mushahid-intesum/3d-obj-detection/python/merge_sessions.py

import os
import json
import glob
import time

import numpy as np
from PIL import Image

DATA_ROOT           = "./data"
OUTPUT_DIR          = "./data/merged"
MIN_SEGMENT_LENGTH  = 5
IMG_SIZE            = 96


def discover_sessions(data_root):
    sessions = []
    for entry in sorted(os.listdir(data_root)):
        subdir = os.path.join(data_root, entry)
        traj_path = os.path.join(subdir, "trajectory.jsonl")
        if os.path.isdir(subdir) and os.path.isfile(traj_path):
            sessions.append(subdir)

    sessions = [s for s in sessions if os.path.abspath(s) !=
                os.path.abspath(OUTPUT_DIR)]

    print(f"[Discover] Found {len(sessions)} sessions:")
    for s in sessions:
        print(f"  - {os.path.basename(s)}")
    return sessions


def load_session(session_dir):
    traj_path = os.path.join(session_dir, "trajectory.jsonl")
    img_dir = os.path.join(session_dir, "images")

    trajectory = []
    with open(traj_path, "r") as f:
        for line in f:
            line = line.strip()
            if line:
                trajectory.append(json.loads(line))

    if not trajectory:
        print(f"  [WARN] Empty trajectory in {session_dir}")
        return None, None

    frames = []
    for step in trajectory:
        img_path = os.path.join(img_dir, step["frame"])
        if not os.path.exists(img_path):
            print(f"  [WARN] Missing image: {img_path}")
            return None, None
        img = Image.open(img_path).convert("RGB")
        if img.size != (IMG_SIZE, IMG_SIZE):
            img = img.resize((IMG_SIZE, IMG_SIZE), Image.LANCZOS)
        frames.append(np.array(img, dtype=np.uint8))

    frames = np.stack(frames, axis=0)
    return frames, trajectory


def find_segments(trajectory, min_length=MIN_SEGMENT_LENGTH):
    segments = []
    seg_start = 0

    for i, step in enumerate(trajectory):
        if step.get("blocked", False):
            if i - seg_start >= min_length:
                segments.append((seg_start, i))
            seg_start = i + 1

    if len(trajectory) - seg_start >= min_length:
        segments.append((seg_start, len(trajectory)))

    return segments


def main():
    print("=" * 50)
    print("  Merge Exploration Sessions")
    print("=" * 50)

    t_start = time.time()
    os.makedirs(OUTPUT_DIR, exist_ok=True)

    sessions = discover_sessions(DATA_ROOT)
    if not sessions:
        print("\n[ERROR] No sessions found. Run receiver.py first.")
        return

    all_segments = []
    total_frames = 0

    for sess_dir in sessions:
        print(f"\n[*] Loading: {os.path.basename(sess_dir)}")
        frames, trajectory = load_session(sess_dir)
        if frames is None:
            continue

        segments = find_segments(trajectory)
        print(f"    {len(frames)} frames → {len(segments)} segments")

        for seg_start, seg_end in segments:
            seg_len = seg_end - seg_start
            seg_frames = frames[seg_start:seg_end]
            seg_actions = np.array([
                trajectory[i]["action"] for i in range(seg_start, seg_end)
            ], dtype=np.int32)
            seg_headings = np.array([
                trajectory[i].get("heading", 0.0) for i in range(seg_start, seg_end)
            ], dtype=np.float32)
            seg_proximity = np.array([
                trajectory[i].get("proximity", 255.0) for i in range(seg_start, seg_end)
            ], dtype=np.float32)

            all_segments.append({
                "frames": seg_frames,
                "actions": seg_actions,
                "headings": seg_headings,
                "proximity": seg_proximity,
                "length": seg_len,
                "source": os.path.basename(sess_dir),
            })
            total_frames += seg_len

    if not all_segments:
        print("\n[ERROR] No valid segments found.")
        return

    print(f"\n[*] Total: {len(all_segments)} segments, {total_frames} frames")

    segment_index = []
    all_frames_list = []
    all_actions_list = []
    all_headings_list = []
    all_proximity_list = []
    offset = 0

    for seg in all_segments:
        seg_len = seg["length"]
        all_frames_list.append(seg["frames"])
        all_actions_list.append(seg["actions"])
        all_headings_list.append(seg["headings"])
        all_proximity_list.append(seg["proximity"])
        segment_index.append({
            "start": offset,
            "end": offset + seg_len,
            "length": seg_len,
            "source": seg["source"],
        })
        offset += seg_len

    all_frames = np.concatenate(all_frames_list, axis=0)
    all_actions = np.concatenate(all_actions_list, axis=0)
    all_headings = np.concatenate(all_headings_list, axis=0)
    all_proximity = np.concatenate(all_proximity_list, axis=0)

    print(f"[*] Saving to {OUTPUT_DIR}...")

    np.savez_compressed(
        os.path.join(OUTPUT_DIR, "dataset.npz"),
        frames=all_frames,
        actions=all_actions,
        headings=all_headings,
        proximity=all_proximity,
    )

    with open(os.path.join(OUTPUT_DIR, "segments.json"), "w") as f:
        json.dump(segment_index, f, indent=2)

    action_names = ["FWD", "RIGHT", "LEFT", "STOP"]
    action_counts = {name: int(np.sum(all_actions == i))
                     for i, name in enumerate(action_names)}

    meta = {
        "total_frames": total_frames,
        "total_segments": len(all_segments),
        "sessions": [os.path.basename(s) for s in sessions],
        "action_distribution": action_counts,
        "img_shape": [96, 96, 3],
        "proximity_stats": {
            "mean": round(float(all_proximity.mean()), 1),
            "min": round(float(all_proximity.min()), 1),
            "max": round(float(all_proximity.max()), 1),
            "blocked_pct": round(float(np.mean(all_proximity < 50.0)) * 100, 1),
        },
    }
    with open(os.path.join(OUTPUT_DIR, "dataset_meta.json"), "w") as f:
        json.dump(meta, f, indent=2)

    elapsed = time.time() - t_start
    size_mb = os.path.getsize(os.path.join(OUTPUT_DIR, "dataset.npz")) / 1e6

    print(f"\n{'=' * 50}")
    print(f"  Merged dataset saved!")
    print(f"  Frames:     {total_frames}")
    print(f"  Segments:   {len(all_segments)}")
    print(f"  Actions:    {action_counts}")
    print(f"  Size:       {size_mb:.1f} MB")
    print(f"  Time:       {elapsed:.1f}s")
    print(f"  Output:     {OUTPUT_DIR}")
    print(f"{'=' * 50}")


if __name__ == "__main__":
    main()
