mushahid-intesum/3d-obj-detection/python/models.py

import torch
import torch.nn as nn
import torch.nn.functional as F


class ResBlock(nn.Module):

    def __init__(self, channels):
        super().__init__()
        self.conv1 = nn.Conv2d(channels, channels, 3, padding=1, bias=False)
        self.bn1 = nn.BatchNorm2d(channels)
        self.conv2 = nn.Conv2d(channels, channels, 3, padding=1, bias=False)
        self.bn2 = nn.BatchNorm2d(channels)

    def forward(self, x):
        residual = x
        out = F.relu(self.bn1(self.conv1(x)))
        out = self.bn2(self.conv2(out))
        return F.relu(out + residual)


class SharedEncoder(nn.Module):

    def __init__(self, feat_dim=512, stage_channels=None, stage_blocks=None):
        super().__init__()
        if stage_channels is None:
            stage_channels = [128, 256, feat_dim]
        if stage_blocks is None:
            stage_blocks = [3, 4, 3]

        layers = []
        in_ch = 3
        for ch, n_blocks in zip(stage_channels, stage_blocks):
            layers.extend([
                nn.Conv2d(in_ch, ch, 3, stride=2, padding=1, bias=False),
                nn.BatchNorm2d(ch),
                nn.ReLU(inplace=True),
            ])
            for _ in range(n_blocks):
                layers.append(ResBlock(ch))
            in_ch = ch

        self.net = nn.Sequential(*layers)
        self.feat_dim = stage_channels[-1]

    def forward(self, x):
        return self.net(x)


class CorrelationModule(nn.Module):

    def __init__(self, feat_h=12, feat_w=12, feat_dim=512, pyramid_levels=2,
                 lookup_radius=1, cue_dim=512):
        super().__init__()
        self.feat_h = feat_h
        self.feat_w = feat_w
        self.r = lookup_radius
        self.k = 2 * lookup_radius + 1
        self.pyramid_levels = pyramid_levels

        lookup_ch = (pyramid_levels + 1) * (self.k ** 2)
        pool_size = 8
        self.fusion = nn.Sequential(
            nn.Conv2d(lookup_ch, 128, 3, padding=1, bias=False),
            nn.BatchNorm2d(128), nn.ReLU(inplace=True),
            nn.Conv2d(128, 64, 3, padding=1, bias=False),
            nn.BatchNorm2d(64), nn.ReLU(inplace=True),
            nn.AdaptiveAvgPool2d(pool_size),
        )

        fused_size = 64 * pool_size * pool_size
        self.fc = nn.Sequential(
            nn.Linear(fused_size, cue_dim),
            nn.ReLU(inplace=True),
        )

    def _cross_correlation(self, f_goal, f_obs):
        B, C, H, W = f_goal.shape
        N = H * W
        g = F.normalize(f_goal.view(B, C, N), dim=1)
        o = F.normalize(f_obs.view(B, C, N), dim=1)
        return torch.bmm(g.permute(0, 2, 1), o)

    def _build_pyramid(self, corr):
        B, N_o = corr.shape[0], corr.shape[2]
        H, W = self.feat_h, self.feat_w
        c = corr.view(B, H, W, N_o)
        pyramid = [corr]

        for _ in range(self.pyramid_levels):
            cur_h, cur_w = c.shape[1], c.shape[2]
            c_pool = c.permute(0, 3, 1, 2).reshape(B * N_o, 1, cur_h, cur_w)
            new_h, new_w = max(1, cur_h // 2), max(1, cur_w // 2)
            c_pool = F.adaptive_avg_pool2d(c_pool, (new_h, new_w))
            c = c_pool.reshape(B, N_o, new_h, new_w).permute(0, 2, 3, 1)
            pyramid.append(c.reshape(B, new_h * new_w, N_o))

        return pyramid

    def _direction_lookup(self, pyramid):
        B = pyramid[0].shape[0]
        H, W = self.feat_h, self.feat_w
        lookups = []

        for corr_s in pyramid:
            N_g_s = corr_s.shape[1]
            H_g_s = max(1, int(N_g_s ** 0.5))
            W_g_s = max(1, N_g_s // H_g_s)

            corr_2d = corr_s.view(B, H_g_s, W_g_s, H * W).permute(0, 3, 1, 2)
            padded = F.pad(corr_2d, [self.r] * 4, mode="constant", value=0)

            patches = []
            for oy in range(H):
                for ox in range(W):
                    j = oy * W + ox
                    gy = int(oy * H_g_s / H)
                    gx = int(ox * W_g_s / W)
                    patch = padded[:, j, gy:gy + self.k, gx:gx + self.k]
                    patches.append(patch.reshape(B, self.k ** 2))

            lookup = torch.stack(patches, dim=1).view(B, H, W, self.k ** 2)
            lookups.append(lookup)

        return torch.cat(lookups, dim=-1)

    def forward(self, f_goal, f_obs):
        corr = self._cross_correlation(f_goal, f_obs)
        pyramid = self._build_pyramid(corr)
        lookup = self._direction_lookup(pyramid)
        x = lookup.permute(0, 3, 1, 2)
        x = self.fusion(x)
        x = x.reshape(x.size(0), -1)
        return self.fc(x)


class PolicyNetwork(nn.Module):

    def __init__(self, cue_dim=512, hidden=256, num_actions=4):
        super().__init__()
        self.net = nn.Sequential(
            nn.Linear(cue_dim + 1, hidden), nn.ReLU(inplace=True),
            nn.Linear(hidden, 128), nn.ReLU(inplace=True),
            nn.Linear(128, num_actions),
        )

    def forward(self, cue, obs_proximity):
        x = torch.cat([cue, obs_proximity.unsqueeze(-1)], dim=-1)
        return self.net(x)


class QNetwork(nn.Module):

    def __init__(self, cue_dim=512, hidden=256, num_actions=4):
        super().__init__()
        self.action_embed = nn.Embedding(num_actions, 32)
        self.net = nn.Sequential(
            nn.Linear(cue_dim + 1 + 32, hidden), nn.ReLU(inplace=True),
            nn.Linear(hidden, 128), nn.ReLU(inplace=True),
            nn.Linear(128, 1),
        )

    def forward(self, cue, obs_proximity, actions):
        a_emb = self.action_embed(actions)
        x = torch.cat([cue, obs_proximity.unsqueeze(-1),
                        a_emb], dim=-1)
        return self.net(x).squeeze(-1)


class VNetwork(nn.Module):

    def __init__(self, cue_dim=512, hidden=256):
        super().__init__()
        self.net = nn.Sequential(
            nn.Linear(cue_dim + 1, hidden), nn.ReLU(inplace=True),
            nn.Linear(hidden, 128), nn.ReLU(inplace=True),
            nn.Linear(128, 1),
        )

    def forward(self, cue, obs_proximity):
        x = torch.cat([cue, obs_proximity.unsqueeze(-1)], dim=-1)
        return self.net(x).squeeze(-1)


class TeacherModel(nn.Module):

    def __init__(self, feat_dim=512, cue_dim=512, num_actions=4):
        super().__init__()
        self.encoder = SharedEncoder(feat_dim=feat_dim)
        self.correlation = CorrelationModule(
            feat_h=12, feat_w=12, feat_dim=feat_dim,
            pyramid_levels=2, cue_dim=cue_dim,
        )
        self.policy = PolicyNetwork(cue_dim, num_actions=num_actions)

        self.q1 = QNetwork(cue_dim, num_actions=num_actions)
        self.q2 = QNetwork(cue_dim, num_actions=num_actions)
        self.v = VNetwork(cue_dim)

    def encode_and_correlate(self, obs, goal):
        f_obs = self.encoder(obs)
        f_goal = self.encoder(goal)
        return self.correlation(f_goal, f_obs)

    def forward(self, obs, goal, obs_proximity):
        f_obs = self.encoder(obs)
        f_goal = self.encoder(goal)

        cue = self.correlation(f_goal, f_obs)
        action_logits = self.policy(cue, obs_proximity)

        return action_logits

    def get_action(self, obs, goal, obs_proximity):
        with torch.no_grad():
            logits = self.forward(obs, goal, obs_proximity)
            return logits.argmax(dim=-1)

    def count_params(self):
        counts = {}
        counts["encoder"] = sum(p.numel() for p in self.encoder.parameters())
        counts["correlation"] = sum(
            p.numel() for p in self.correlation.parameters()
        )
        counts["policy"] = sum(p.numel() for p in self.policy.parameters())
        counts["q1"] = sum(p.numel() for p in self.q1.parameters())
        counts["q2"] = sum(p.numel() for p in self.q2.parameters())
        counts["v"] = sum(p.numel() for p in self.v.parameters())
        counts["total"] = sum(counts.values())
        return counts
