mushahid-intesum/3d-obj-detection/firmware/esp32/main/image_proc.c

#include "image_proc.h"
#include <string.h>

void image_downsample(const uint8_t *src_rgb565, int src_w, int src_h,
                      uint8_t *dst_rgb888)
{


    for (int dy = 0; dy < IMG_TARGET_H; dy++) {

        int sy_start = (dy * src_h) / IMG_TARGET_H;
        int sy_end   = ((dy + 1) * src_h) / IMG_TARGET_H;

        for (int dx = 0; dx < IMG_TARGET_W; dx++) {

            int sx_start = (dx * src_w) / IMG_TARGET_W;
            int sx_end   = ((dx + 1) * src_w) / IMG_TARGET_W;


            uint32_t acc_r = 0, acc_g = 0, acc_b = 0;
            int count = 0;

            for (int sy = sy_start; sy < sy_end; sy++) {
                const uint16_t *row = (const uint16_t *)(src_rgb565 + sy * src_w * 2);
                for (int sx = sx_start; sx < sx_end; sx++) {
                    uint8_t r, g, b;
                    rgb565_to_rgb888(row[sx], &r, &g, &b);
                    acc_r += r;
                    acc_g += g;
                    acc_b += b;
                    count++;
                }
            }


            int out_idx = (dy * IMG_TARGET_W + dx) * 3;
            if (count > 0) {
                dst_rgb888[out_idx + 0] = (uint8_t)(acc_r / count);
                dst_rgb888[out_idx + 1] = (uint8_t)(acc_g / count);
                dst_rgb888[out_idx + 2] = (uint8_t)(acc_b / count);
            } else {
                dst_rgb888[out_idx + 0] = 0;
                dst_rgb888[out_idx + 1] = 0;
                dst_rgb888[out_idx + 2] = 0;
            }
        }
    }
}
