mushahid-intesum/3d-obj-detection/esp32/motor_board/main/inference.c

/**
 * @file inference.c
 * @brief Inference stub for Motor Board — compiles without TFLite.
 *
 * Returns ESP_ERR_NOT_FOUND from inference_init(), which causes
 * main.c to select collection mode (pink noise explorer).
 *
 * When models are ready:
 *   1. Add tflite-micro component to idf_component.yml
 *   2. Delete this file
 *   3. Rename inference_tflite.cpp → inference.cpp
 *   4. Uncomment the #include "policy_model.h" line
 */
#include "inference.h"
#include "esp_log.h"

#include <string.h>

static const char *TAG = "inference";

esp_err_t inference_init(void)
{
    ESP_LOGW(TAG, "TFLite not linked — policy stub active (collection mode).");
    return ESP_ERR_NOT_FOUND;
}

esp_err_t inference_run_policy(const int8_t *corr_cue, int8_t *action_logits)
{
    (void)corr_cue;
    (void)action_logits;
    return ESP_ERR_INVALID_STATE;
}

int inference_argmax_i8(const int8_t *arr, int len)
{
    int best_idx = 0;
    int8_t best_val = arr[0];
    for (int i = 1; i < len; i++) {
        if (arr[i] > best_val) {
            best_val = arr[i];
            best_idx = i;
        }
    }
    return best_idx;
}
