mushahid-intesum/3d-obj-detection/(commit log)

2026-10-07 Phase 1: ESP32-S3 firmware foundation
    - OV3660 camera driver (320x240 RGB565, double-buffered DMA)
    - HC-SR04 ultrasonic with median filter + 10Hz background polling
    - Differential-drive motor control via LEDC PWM
    - Area-averaged image downscaler (320x240 -> 48x48 RGB888)
    - WiFi STA + TCP server for laptop streaming
    - Python receiver with live preview and frame saving
    - Pin config placeholders, Kconfig for WiFi creds
2026-10-07 Phase 2: Pink-noise exploration and data collection pipeline
    - pink_noise.py: 1/f noise generator with probability integral transform
    (Gaussian -> Uniform via CDF), discrete action mapping, visualization
    - explorer.py: Main exploration controller — connects to ESP32, sends
    pink-noise actions, receives 48x48 frames, saves trajectory + metadata
    - merge_sessions.py: Merges multiple sessions, segments at overrides,
    outputs compressed dataset.npz ready for Phase 3 relabeling
    - Updated requirements.txt with scipy and matplotlib
    [explorer.py, merge_sessions.py, pink_noise.py]
2026-10-07 Refactor: replace argparse with in-code constants in all Python scripts
    - receiver.py: ESP32_HOST, ESP32_PORT, SAVE_DIR constants
    - explorer.py: ESP32_HOST, OUTPUT_DIR, DURATION_SEC, RATE_HZ, BETA, SEED
    - merge_sessions.py: SESSION_DIRS, OUTPUT_DIR, MIN_SEGMENT_LENGTH
    - pink_noise.py: LENGTH, BETA, SEED in __main__ block
    [explorer.py, merge_sessions.py, pink_noise.py, receiver.py]
2026-10-07 Phase 3: Hindsight goal relabeling and PyTorch dataset
    - hindsight_relabel.py: Samples future frames as goals for each timestep,
    assigns terminal reward (+5.0 if within 3 steps) or step penalty (-0.01).
    Stores transitions as index references to avoid duplicating image data.
    - dataset.py: PyTorch Dataset with on-the-fly augmentation (horizontal flip
    with action swap, brightness/contrast jitter). Includes DataLoader factory.
    - Added torch to requirements.txt
    [dataset.py, hindsight_relabel.py]
2026-10-07 Phase 4: Teacher model and IQL offline RL training
    - models.py: Full teacher architecture
    - SharedEncoder: ResNet-9 weight-shared encoder (48x48 → 6x6x128 feature maps)
    - CorrelationModule: Cross-correlation + pyramid (2 levels) + 3x3 direction-aware lookup + conv fusion → 256-dim cue
    - PolicyNetwork / QNetwork / VNetwork: IQL actor-critic heads
    - TeacherModel: Combined wrapper with encode_and_correlate()
    - train_teacher.py: IQL training loop
    - Expectile regression V loss (tau=0.7)
    - Twin Q networks with Bellman TD loss
    - Advantage-weighted policy regression (beta=3.0)
    - Polyak-averaged target networks (tau=0.005)
    - Gradient clipping, periodic eval, best checkpoint tra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
2026-10-07 Phase 5: Knowledge distillation (teacher → student)
    - student_model.py: MCU-deployable student (~10K params)
    - TinyEncoder: 1 standard conv + 3 depthwise-separable (48x48 → 3x3x32)
    - SimplifiedCorrelation: 9x9 cross-correlation + 2 L/R scores = 83-dim cue
    - TinyPolicy: 83→64→32→4 MLP
    - Temporary corr_projector (83→256) for distillation, excluded from deploy
    - distill.py: Dual-level distillation training
    - L_action: KL divergence with temperature scaling (T=4)
    - L_corr: MSE between projected student cue and teacher cue
    - L_hard: Cross-entropy with teacher argmax labels
    - Cosine LR schedule, per-action accuracy eval, deploy-only checkpoints
2026-10-07 Phase 6: Quantization, TFLite export, and ESP32 C headers
    - quantize_export.py: Full export pipeline
    1. QAT fine-tuning (10K steps with distillation loss under fake quantization)
    2. Split export: encoder.onnx + policy.onnx (separate models)
    3. ONNX → TFLite INT8 conversion with representative dataset calibration
    4. tflite_to_c_header(): generates encoder_model.h and policy_model.h
    for direct embedding in ESP32 firmware via #include
    5. FP32 baseline accuracy validation
    - Updated requirements.txt with onnx, onnx-tf, tensorflow
2026-10-07 Phase 7: MCU deployment — autonomous navigation firmware
    ESP32 firmware (new files):
    - correlation.c: Pure INT8 cross-correlation in plain C
    - 9x9 cosine similarity with integer sqrt approximation
    - L/R spatial similarity scores
    - No floating point — runs entirely in INT32 arithmetic
    - inference.cpp: TFLite Micro wrapper
    - Dual interpreters: encoder (80KB arena) + policy (16KB arena)
    - uint8 → int8 image conversion for quantized input
    - Placeholder model data — replace with real .h includes from Phase 6
    - navigator.c: Main navigation loop
    - Goal caching: encode goal ONCE → 288 bytes cached in SRAM
    - Per-step: capture → downsample → encode → correlate → pol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
    [correlation.c, correlation.h, inference.cpp, inference.h, main.c, navigator.c, navigator.h]
2026-10-07 Refactor: unified config.h + DRV8833 motor driver + OV3660 camera
    Hardware changes:
    - Replaced pin_config.h with unified config.h containing all hardware params
    - Camera: dual-mode init (JPEG for streaming, RGB565 for inference),
    LEDC timer 1 / channel 2 (avoids motor PWM), sccb_i2c_port=-1
    - Motor: DRV8833 driver with IN1-IN4 + ENA/ENB, unified set_speed()
    - Actions: 6 discrete (NORTH/SOUTH/EAST/WEST/STAY/INTERACT)
    - Ultrasonic: constants from config.h (US_TIMEOUT_US, US_POLL_MS, US_OBSTACLE_CM)
    Updated files:
    - camera.c/h: camera_init_jpeg() / camera_init_rgb() + camera_capture_frame()
    - motor.c/h: DRV8833 API matching user's existing driver
    - ultrasonic.c: uses config.h constants
    - mai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
    [camera.c, config.h, explorer.py, main.c, motor.c, motor.h, navigator.c]
2026-10-07 Add HOW_TO_RUN.md — comprehensive step-by-step guide
    Covers all 7 phases end-to-end:
    - Step 0: Pin wiring + config.h + WiFi credentials
    - Step 1: Build & flash firmware
    - Step 2: Hardware validation with receiver.py
    - Step 3: Data collection (explorer.py + merge_sessions.py)
    - Step 4: Hindsight goal relabeling (offline RL dataset)
    - Step 5: Teacher model training (IQL, GPU)
    - Step 6: Knowledge distillation (teacher → student)
    - Step 7: Quantization + TFLite INT8 export + C header generation
    - Step 8: Deploy to ESP32 (model includes + navigation mode)
    Includes: prerequisites, quick command reference, file map, troubleshooting
2026-10-07 Fix ESP-IDF v6.1 build + set actual hardware pin config
    ESP-IDF v6.1 migration:
    - CMakeLists.txt: driver → esp_driver_gpio + esp_driver_ledc
    - wifi_stream.c: add missing #include image_proc.h
    Hardware pin config (from user's wiring):
    - Camera: OV5640 on ESP32-S3-WROOM (XCLK=15, SDA=4, SCL=5,
    D0-D7=11,9,8,10,12,18,17,16, VSYNC=6, HREF=7, PCLK=13, 10MHz)
    - Motor DRV8833: IN1-4=35-38, ENA=39, ENB=40, speed=100, fwd=500ms
    - Ultrasonic HC-SR04: trig=GPIO1, echo=GPIO2
    - Button: GPIO0 (BOOT), LED: GPIO48
    [config.h, motor.c, wifi_stream.c]
2026-10-07 Fix linker errors + remove button/LED
    - inference.h: add extern "C" guards so C++ functions are exported
    with C linkage (fixes undefined reference from navigator.c)
    - Remove LED_STATUS_PIN and BTN_GOAL_PIN from config.h
    - navigator: replace button-based goal capture with 3-second delay
    auto-capture (NAV_GOAL_AUTO_CAPTURE)
    - main.c: update to use NAV_GOAL_AUTO_CAPTURE
    [config.h, inference.h, main.c, navigator.c, navigator.h]
2026-10-07 Switch to MODE_COLLECT + fix PSRAM speed
    - PSRAM 80MHz → 40MHz in sdkconfig.defaults (memory test fail)
    - MODE_NAVIGATE → MODE_COLLECT (test camera/WiFi first)
    - Camera WDT crash on I2C probe needs investigation
    [main.c]
2026-10-07 Fix camera WDT crash: OV3660 needs 20MHz XCLK
    The OV3660 requires ≥20MHz XCLK to lock its internal PLL.
    At 10MHz the camera stays powered down and never responds
    on I2C (SCCB), causing the probe to hang and trigger WDT.
    - CAM_XCLK_FREQ: 10MHz → 20MHz
    - Fixed comment: OV5640 → OV3660
    [config.h]
2026-10-07 Fix camera PWDN pin + resolve GPIO38 conflict
    Root cause: The Freenove ESP32-S3 WROOM connects the camera's
    power-down pin to GPIO38. With PWDN set to -1, the camera was
    never powered on, causing the I2C/SCCB probe to hang and trigger
    a watchdog reset.
    Fix: Set CAM_PIN_PWDN=38 per the official espressif/esp32-camera
    BOARD_ESP32S3_WROOM reference config.
    GPIO38 was previously used by MOTOR_IN4, so motor pins reshuffled:
    - MOTOR_IN4: 38 → 14
    - MOTOR_ENA: 39 → 21
    - MOTOR_ENB: 40 → 47
    (IN1=35, IN2=36, IN3=37 unchanged — no conflict with camera)
    [config.h]
2026-10-07 Rewrite camera.c using esp32-camera library properly
    Following the official espressif/esp32-camera example exactly:
    - PWDN = -1 (Freenove board doesn't use it)
    - LEDC_TIMER_0 / LEDC_CHANNEL_0 for XCLK (library default)
    - CAMERA_GRAB_WHEN_EMPTY, fb_count=1
    - No sccb_i2c_port field (let library auto-detect)
    - Proper PWDN GPIO handling from README (drive LOW if defined)
    Also fixed LEDC conflict:
    - Camera: LEDC_TIMER_0, CHANNEL_0
    - Motor A: LEDC_TIMER_1, CHANNEL_2
    - Motor B: LEDC_TIMER_1, CHANNEL_3
    Moved US_ECHO from GPIO2 to GPIO3 (GPIO2 = Freenove flash LED).
    Restored motor pins 35-40 (no conflict since PWDN is not 38).
    [camera.c, config.h, motor.c]
2026-10-07 Fix camera.c compile errors
    - PWDN guard: runtime if() → preprocessor #if so compiler never
    evaluates 1ULL << (-1) which triggers -Werror=shift-count-negative
    - Add missing FreeRTOS includes for vTaskDelay/pdMS_TO_TICKS
    [camera.c]
2026-10-07 Fix camera WDT: remove sccb_i2c_port, fix LEDC conflicts
    Root cause: camera.c had sccb_i2c_port=-1 which caused I2C bus
    issues, and motor.c used LEDC_TIMER_0/CH_0,1 — the same timer
    the camera needs for XCLK generation.
    Fixes:
    - camera.c: removed sccb_i2c_port=-1 (let driver auto-detect),
    match official esp32-camera example config exactly
    (LEDC_TIMER_0/CH_0, CAMERA_GRAB_WHEN_EMPTY, fb_count=1)
    - motor.c: moved to LEDC_TIMER_1 + CHANNEL_2,3 (no conflict)
    - main.c: camera inits BEFORE motor in both modes
    - config.h: reverted CAM_PIN_PWDN to -1 per user's board
    [camera.c, config.h, main.c]
2026-10-07 Add WiFi timeout to prevent WDT on bad credentials
    wifi_stream.c: changed portMAX_DELAY to 30s timeout so WiFi
    init fails gracefully instead of triggering watchdog reset
    when SSID/password are wrong or network is unavailable.
    [wifi_stream.c]
2026-10-07 Debug WiFi WDT: increase timeouts + add step logging
    - WDT timeout: 5s → 30s (WiFi init can be slow)
    - Main task stack: 8KB → 16KB (camera + wifi init together)
    - Flash size: 2MB → 16MB (matches detected hardware)
    - wifi_stream.c: step-by-step [1/7]..[7/7] logging to pinpoint
    exact WiFi call that hangs
    - Removed WiFi creds from sdkconfig.defaults (now in code)
2026-10-07 Move esp_netif_init to early app_main, fix WiFi WDT
    Root cause: esp_netif_init() was being called deep in the call
    stack (app_main → wifi_init_sta) after camera+motor init had
    already consumed stack/heap. Moving it to early app_main ensures
    the TCP/IP stack initializes with full resources available.
    - main.c: call esp_netif_init() + esp_event_loop_create_default()
    right after NVS init, before any peripheral init
    - wifi_stream.c: removed those calls from wifi_init_sta()
    (avoid double-init)
    [main.c, wifi_stream.c]
2026-10-07 Add missing esp_netif.h and esp_event.h includes to main.c
    [main.c]
2026-10-07 Fix motor WDT: GPIOs 35-37 are PSRAM pins on ESP32-S3
    On ESP32-S3 with octal PSRAM enabled, GPIOs 33-37 are used by
    the PSRAM data bus and CANNOT be used as regular GPIOs.
    Configuring them as output crashes the system.
    Moved motor pins to free GPIOs:
    IN1: 35 → 38
    IN2: 36 → 39
    IN3: 37 → 40
    IN4: 14 → 41
    ENA: 21 → 42
    ENB: 47 → 14
    All new pins (38-42, 14) are free on the Freenove board.
    GPIOs 38-42 are JTAG pins but usable as GPIO when JTAG is
    not connected (which is the normal case).
    [config.h]
2026-10-08 Implement autonomous 8-direction data collection
    At each position, the robot:
    1. Sweeps 8 directions (N,NE,E,SE,S,SW,W,NW) with 45° pivots
    2. Takes 3 photos per direction (24 photos/position)
    3. Rotates back to original heading
    4. Moves forward one cell
    Stopping: if ultrasonic detects a barrier for 3 consecutive
    forward attempts, the program stops.
    Timing constants (TUNE MANUALLY — no IMU):
    - TURN_45_MS = 175ms (45° pivot)
    - TURN_90_MS = 350ms (90° pivot)
    - FORWARD_MS = 500ms (one grid cell)
    - COLLECT_SETTLE_MS = 200ms (stabilize after turn)
    Also: TURN_MS renamed to TURN_90_MS for clarity.
    [config.h, main.c, motor.c]
2026-10-08 Remove ultrasonic sensor, switch to depth-distilled policy
    Design decision: no ultrasonic hardware. Depth understanding is
    handled end-to-end by the navigation policy using MiDaS depth
    maps as auxiliary training signal (depth head stripped at deploy).
    Changes:
    - config.h: removed US_* defines, added COLLECT_MAX_POSITIONS
    - main.c: removed ultrasonic init/reads, simplified collection
    loop (runs until max positions or TCP disconnect)
    - wifi_stream: new protocol v2 (IMG2) sends raw JPEG frames
    with direction index instead of fixed 48×48 RGB + ultrasonic
    - CMakeLists.txt: removed ultrasonic.c and image_proc.c from build
    Stream packet format (v2):
    [4B] magic 'IMG2'
    [4B] frame_id
    [1B]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
    [config.h, main.c, wifi_stream.c]
2026-10-08 Add IMU (Arduino Nano 33 BLE Rev2) for closed-loop heading
    Arduino side:
    - BMI270 gyroscope + BMM150 magnetometer
    - Complementary filter (98% gyro + 2% mag)
    - Sends 'H:<heading>' at 50Hz over UART
    ESP32 side:
    - imu_uart.c: UART1 reader on GPIO3(RX)/GPIO48(TX)
    - Background task parses heading, thread-safe access
    - motor.c: motor_turn_to_heading() for exact turns
    with ±3° tolerance and timeout safety
    - Falls back to open-loop if IMU not connected
    Data collection uses IMU:
    - Records initial heading at each position
    - Closed-loop 45° sweeps (exact, battery-invariant)
    - Each photo tagged with TRUE heading (float32)
    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
    [imu_heading.ino, imu_uart.c, imu_uart.h, main.c, motor.c, motor.h, wifi_stream.c]
2026-10-08 Add complete data prep + training pipeline
    Data Collection (receiver.py):
    - TCP client for IMG3 protocol (JPEG + IMU heading)
    - Decodes, resizes to 48x48, saves organized images
    - Records metadata.json with heading per frame
    - Live OpenCV preview
    Depth Generation (gen_depth.py):
    - Runs MiDaS Small on all collected images
    - Saves normalized depth maps as .npy
    - Skips already-processed images
    Navigation Graph + Dataset (dataset.py):
    - Builds topological graph from collection metadata
    - Nodes: (position, direction) with images + heading
    - Edges: TURN_RIGHT, TURN_LEFT (intra-pos), FORWARD (inter-pos)
    - BFS shortest path for supervision
    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
    [dataset.py, gen_depth.py, models.py, receiver.py]
2026-10-08 Remove argparse, use in-code constants + auto-discover collections
    All scripts now use editable constants at the top instead of argparse:
    - receiver.py: ESP32_IP, ROOM, START_DIR, etc.
    - gen_depth.py: DATA_DIR, IMG_SIZE, DEVICE
    - train.py: DATA_ROOT, EPOCHS, BATCH_SIZE, LR, etc.
    Dataset auto-discovers all collections under DATA_ROOT:
    - Scans for subdirectories containing metadata.json
    - No need to list directories manually
    - Just arrange rooms under data/ and train on everything
2026-10-08 Fix Arduino IMU: Serial→Serial1 for UART to ESP32
    Critical bug: On Arduino Nano 33 BLE Rev2:
    Serial = USB (Serial Monitor only)
    Serial1 = Hardware UART on D0(RX)/D1(TX)
    The sketch was sending heading data to USB, not to
    the physical TX pin. ESP32 was reading nothing.
    Also:
    - Removed 'while (!Serial)' which blocks until USB
    is connected (ESP32 doesn't need USB)
    - Added delay(1000) instead for IMU warmup
    - Debug output to Serial at 1/10th rate to avoid flooding
    - Heading data goes to Serial1 at full 50Hz
    [imu_heading.ino]
2026-10-08 Fix manual stop: close socket on send failure
    When the laptop receiver is stopped (Ctrl+C), the next send()
    on ESP32 fails. Now we close the socket and set s_client_sock=-1
    so stream_is_connected() returns false and the collection loop
    exits cleanly with a summary.
    [wifi_stream.c]
2026-10-08 Fix models.py: add IQL heads + delete superseded train.py
    models.py:
    - Added QNetwork (cue + action_embed → Q-value scalar)
    - Added VNetwork (cue → V-value scalar)
    - Added encode_and_correlate() method for train_teacher.py/distill.py
    - Added strip_iql_heads() for post-training cleanup
    - count_params() now reports IQL head sizes
    - Kept existing: SharedEncoder, CorrelationModule, DepthDecoder, PolicyNetwork
    train.py:
    - Deleted — superseded by train_teacher.py which has correct IQL loop
    [models.py]
2026-10-08 Phase 0+1: Fix Python pipeline + depth guard model
    Phase 0 (Fix regressions):
    - models.py: Add QNetwork, VNetwork, encode_and_correlate()
    for IQL training. train_teacher.py now imports correctly.
    - dataset.py: Complete rewrite — replaced NavGraph/BFS with
    OfflineNavDataset that loads hindsight-relabeled transitions.
    Serves (obs, goal, action, reward, next_obs, done) batches.
    - gen_depth.py: Default DATA_DIR points to data/ root.
    - train.py was already deleted (superseded by train_teacher.py).
    Phase 1 (Depth guard):
    - train_depth_guard.py: NEW. Trains tiny 3-layer CNN (~14K params)
    to classify obstacle proximity from MiDaS depth maps.
    Replaces ultrasonic sensor on ESP32 Camera Bo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
    [dataset.py, gen_depth.py, models.py, train_depth_guard.py]
2026-10-08 Phase 2A: Camera Board firmware (esp32/cam_board/)
    New ESP-IDF project for ESP32 #1 (Camera Board):
    Files:
    main.c — Collection loop: capture → SPI → stream
    camera.c/h — OV3660 driver (copied from single-board)
    wifi_stream.c/h — IMG4 protocol (22B header: frame_id, timestep,
    action_taken, depth_blocked, heading_deg, jpeg)
    spi_master.c/h — Full-duplex SPI master. Collection mode (6B)
    and navigation mode (290B features).
    config.h — Camera pins + SPI master pins (GPIO 40-42, 2)
    Depth guard is stubbed (obstacle_flag=0) until the TFLite
    model from Phase 1 is deployed.
2026-10-08 Phase 2B: Motor Board firmware (esp32/motor_board/)
    New ESP-IDF project for ESP32 #2 (Motor Board):
    main.c — SPI-slave-synchronized exploration loop
    motor.c/h — DRV8833 driver, updated to 4-action space
    (FWD/RIGHT/LEFT/STOP instead of old NSEW)
    imu_uart.c/h — Arduino IMU heading reader (copied)
    explorer.c/h — NEW: Pink noise via Voss-McCartney algorithm
    (O(1) per sample, no FFT). Pre-computes 2048
    actions, maps through CDF for uniform coverage.
    spi_slave.c/h — NEW: SPI slave driver. Receives obstacle_flag
    from Camera Board, sends heading+action back.
    correlatio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
    [config.h, correlation.c, correlation.h, explorer.c, explorer.h, imu_uart.c, imu_uart.h, main.c]
2026-10-08 Phase 2C+3: Archive old firmware + update data pipeline
    Phase 2C: Archive old single-board firmware
    - Moved esp32/main/ → esp32/archive/main/
    - Moved esp32/CMakeLists.txt, sdkconfig.defaults → archive/
    - Preserved for reference; dual-board projects are now primary
    Phase 3: Data pipeline update for free exploration
    receiver.py (rewritten):
    - IMG3 → IMG4 protocol (22B header with action, blocked, timestep)
    - Position-based saving → trajectory.jsonl (one JSON line/step)
    - Output: data/<session>/trajectory.jsonl + images/frame_NNNNNN.jpg
    - Live preview with obstacle overlay (red BLOCKED text)
    merge_sessions.py (rewritten):
    - Auto-discovers sessions from d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
2026-10-08 Phase 4: Integration test tooling
    WIRING_GUIDE.md — Complete wiring diagram + flash procedure:
    - SPI bus: Camera Board master ↔ Motor Board slave (5 wires)
    - Arduino IMU UART to Motor Board (2 wires)
    - DRV8833 motor driver connections
    - Power requirements, validation checklist (10 items)
    - Step-by-step flash + test procedure
    validate_session.py — Data integrity checker:
    - Validates trajectory.jsonl (JSON parsing, required fields)
    - Checks all referenced images exist and are loadable
    - Verifies action range, heading range, timestamp order
    - Prints per-session pass/fail with statistics
    run_pipeline.py — One-command full data prep:
    - Chain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
    [run_pipeline.py, validate_session.py]
2026-10-08 Phase 5: Training pipeline + navigation firmware
    Phase 5.1-5.3 — Python training stack (verified, already existed):
    train_teacher.py — IQL teacher (1.1M params)
    distill.py — Dual-level KD: KL + correlation MSE + hard CE
    quantize_export.py — QAT → ONNX → TFLite INT8 + C header gen
    student_model.py — 10K deploy params (~10KB INT8)
    All shapes verified: encoder 48x48→3x3x32, policy 83→4
    Phase 5.4 — Camera Board navigation mode:
    inference.cpp — Encoder-only TFLite Micro (80KB arena)
    image_proc.c/h — RGB565→48x48 RGB888 downscaler (from archive)
    main.c — Dual-mode: auto-detects encoder model
    Nav: c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
2026-10-08 Fix cam_board build: remove correlation.h dependency from inference.h
    Camera Board doesn't have correlation.c (that's on Motor Board).
    Replaced #include "correlation.h" with local ENCODER_FEAT_SIZE define.
    Rewrote the header to be encoder-only (no policy references).
    [inference.h]
2026-10-08 Fix build: TFLite stub for collection mode
    Both boards now compile without tflite-micro component:
    - inference.c: pure-C stub returning ESP_ERR_NOT_FOUND
    - inference_tflite.cpp: preserved for when models are ready
    - Removed extern C wrappers (not needed in .c files)
    When models are exported, swap inference.c → inference_tflite.cpp
    and add tflite-micro to idf_component.yml.
    [inference.c, inference_tflite.cpp, main.c]
2026-10-08 Fix motor_board build: add missing FreeRTOS include in spi_slave.c
    pdMS_TO_TICKS requires freertos/FreeRTOS.h — was missing from spi_slave.c.
    [spi_slave.c]
2026-10-09 motor direction fix
2026-10-09 depth prior fix 2
    [gen_depth.py, train_depth_guard.py]
2026-10-10 Motor speeds fixed
2026-10-10 Necessary changes
    [partitions.csv]
2026-10-10 motor board partition
    [partitions.csv]
2026-10-10 non blicking spi and imu logs
2026-10-10 Calibration fix
2026-10-10 RAM issue fix 2
    [inference.cpp, inference_tflite.cpp, main.c]
2026-10-10 RAM issue fix 3
    [inference.cpp, inference.h]
2026-10-10 Ram issue in motor
    [correlation.c, correlation.h, inference.h, inference_tflite.cpp, navigator.c, spi_slave.c]
2026-10-10 SPI fix
2026-10-10 Motor speed
2026-10-10 SPI motor fix
2026-10-10 SPI motor fix 2
    [main.c]
2026-10-11 Cam board
2026-10-11 Cam board 2
2026-10-12 Remove camera board and introduce supesonic phase 1
2026-10-12 Single board consolidation 1A
2026-10-12 Single board consolidation 1 and 2
2026-10-12 Single board consolidation 3
2026-10-12 Single board consolidation 4
2026-10-13 Remove sonar and in proximity phase A
2026-10-13 Remove sonar and in proximity phase B C
2026-10-13 Pin fix and speed fix
2026-10-15 Evaluation framework
